physicsrob/vdm1/README.md

This project contains information on the original VDM-1 (Video Display Module) board manufactured by Processor Technologies, as well as a reproduction board referred to as the VDM-2021.

Visit the docs [Here](https://physicsrob.github.io/vdm1)
