physicsrob/vdm1/docs/history/popular electronics Oct 76 review.pdf

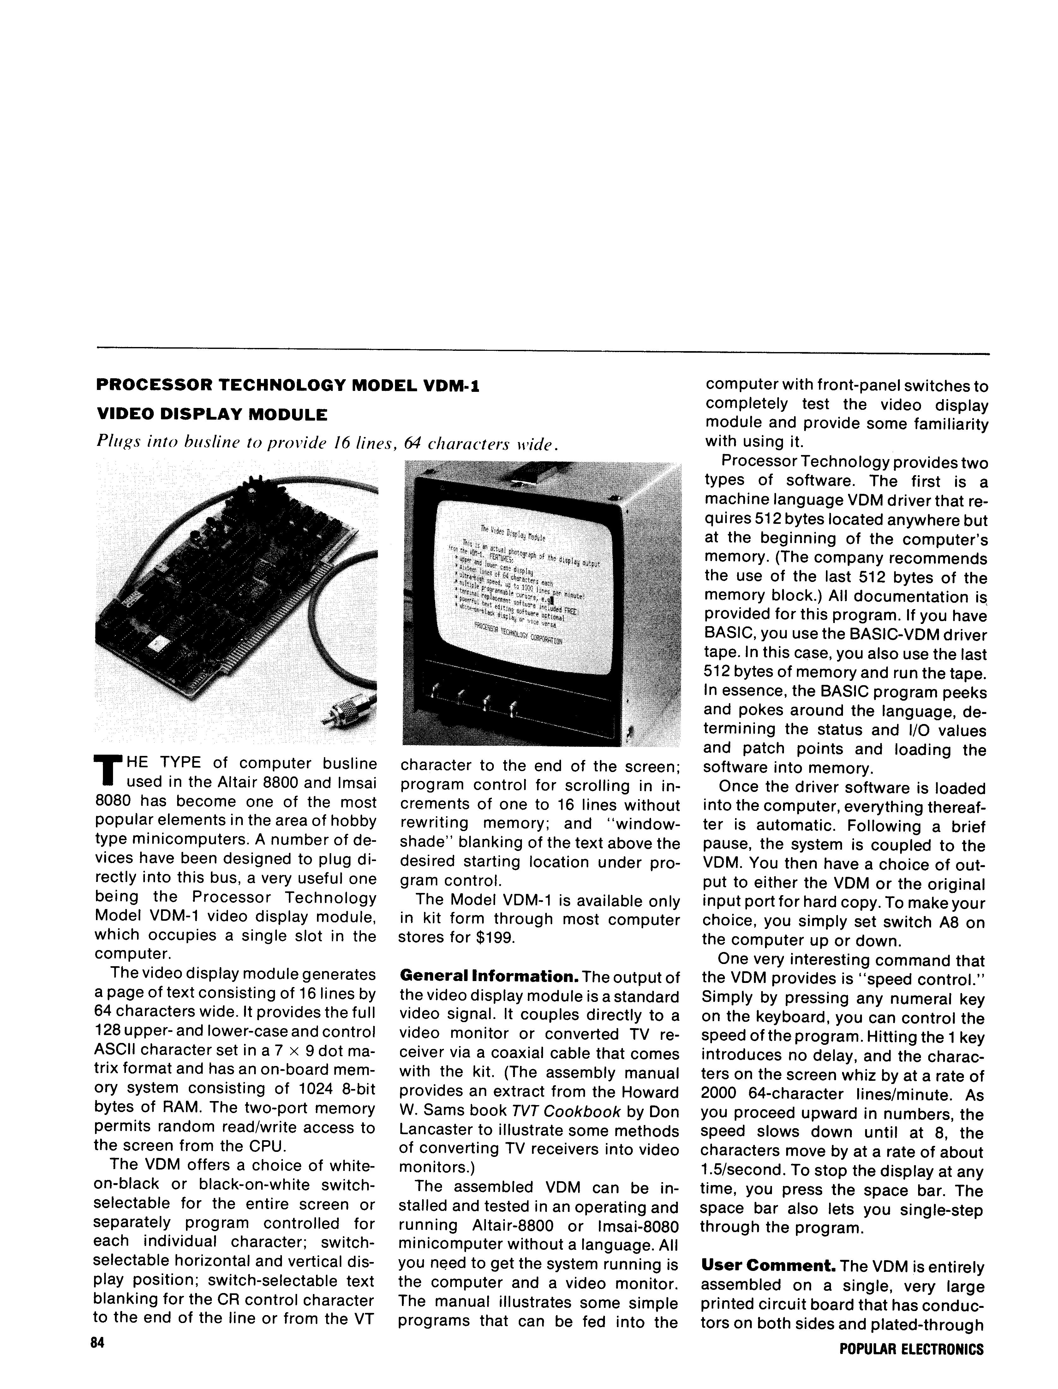
[picture p3: page 1]
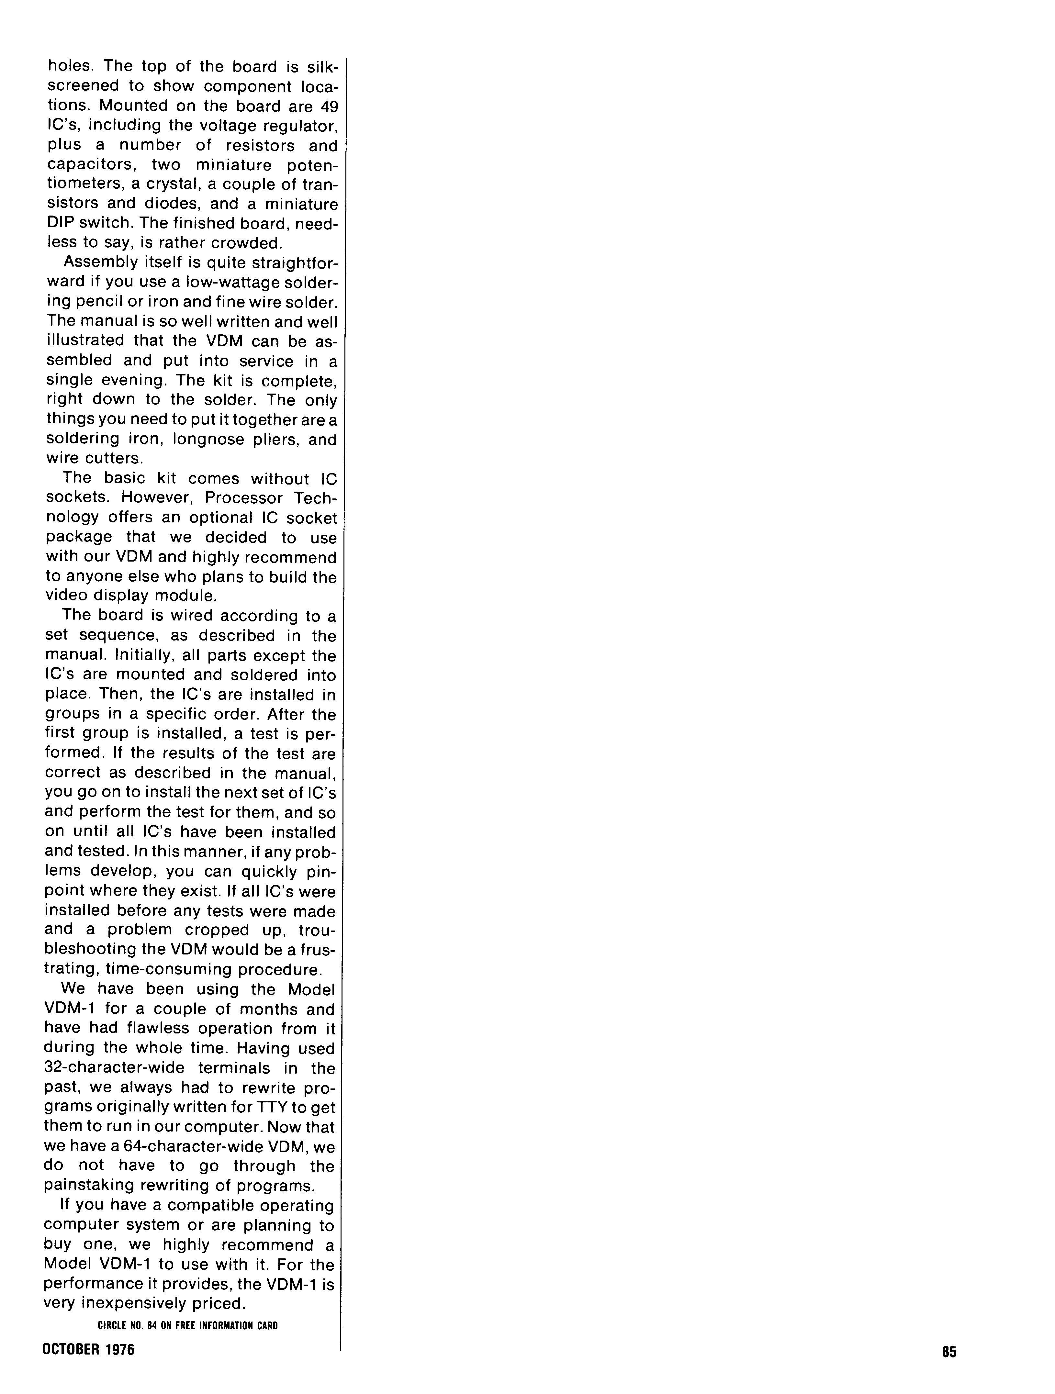
[picture p4: page 2]
