physicsrob/vdm1/docs/history/manuals/schematic rev E.pdf

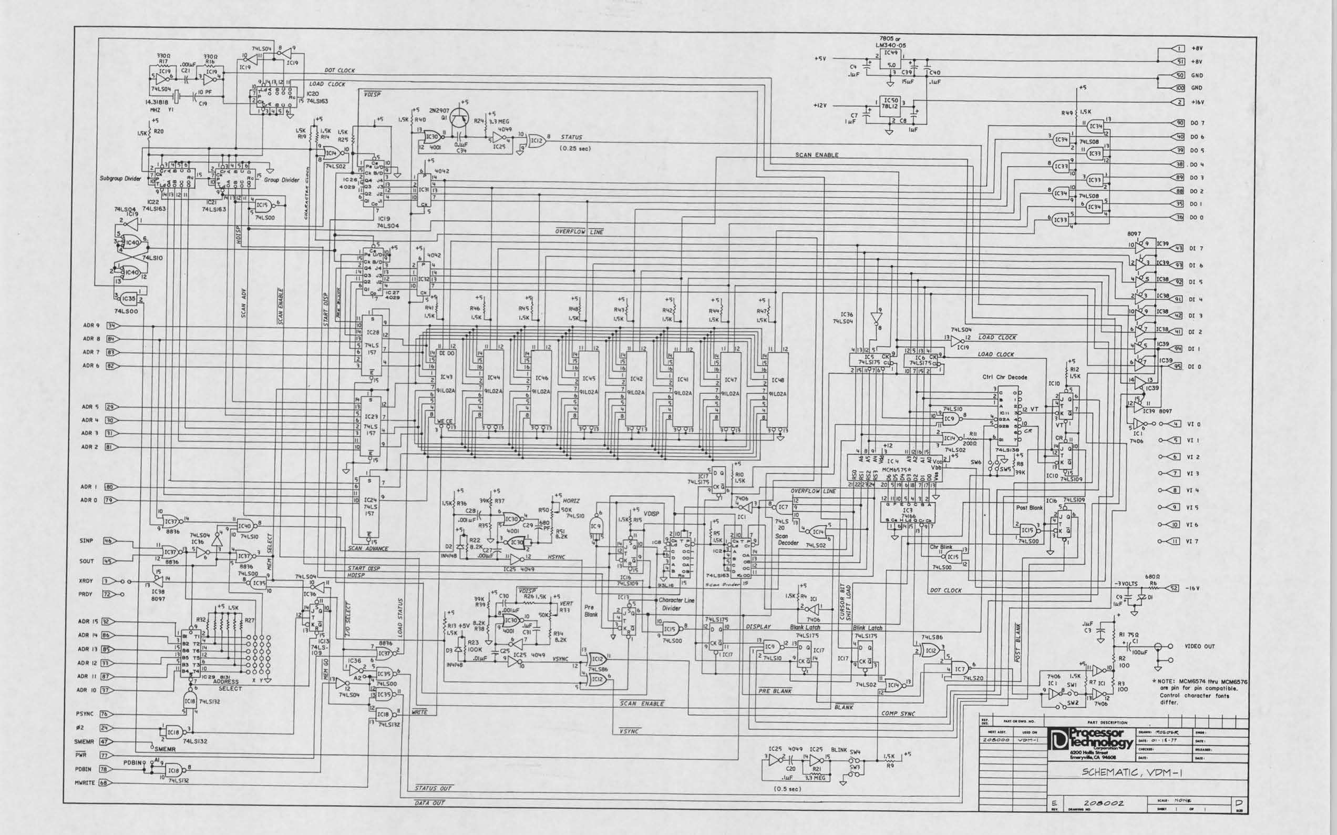
[picture p5: page 1]
