physicsrob/vdm1/docs/images/IC20P12.png

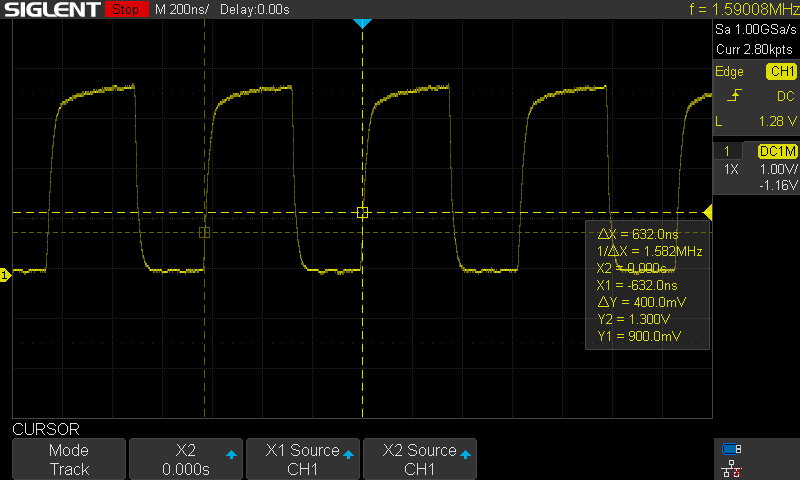
docs/images/IC20P12.png
