physicsrob/vdm1/docs/images/proto_in_chassis.jpg

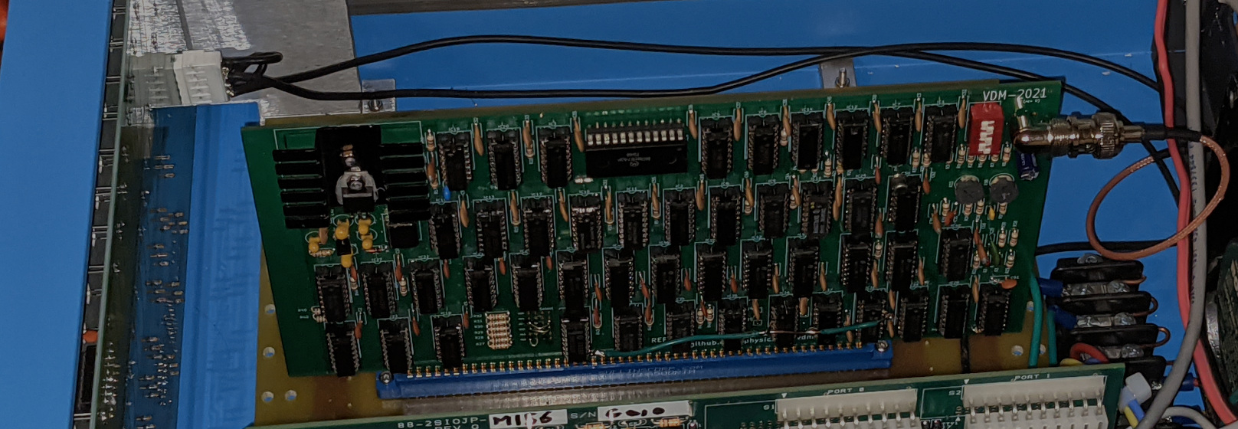
docs/images/proto_in_chassis.jpg
