physicsrob/vdm1/docs/history/manuals/parts rev E.pdf

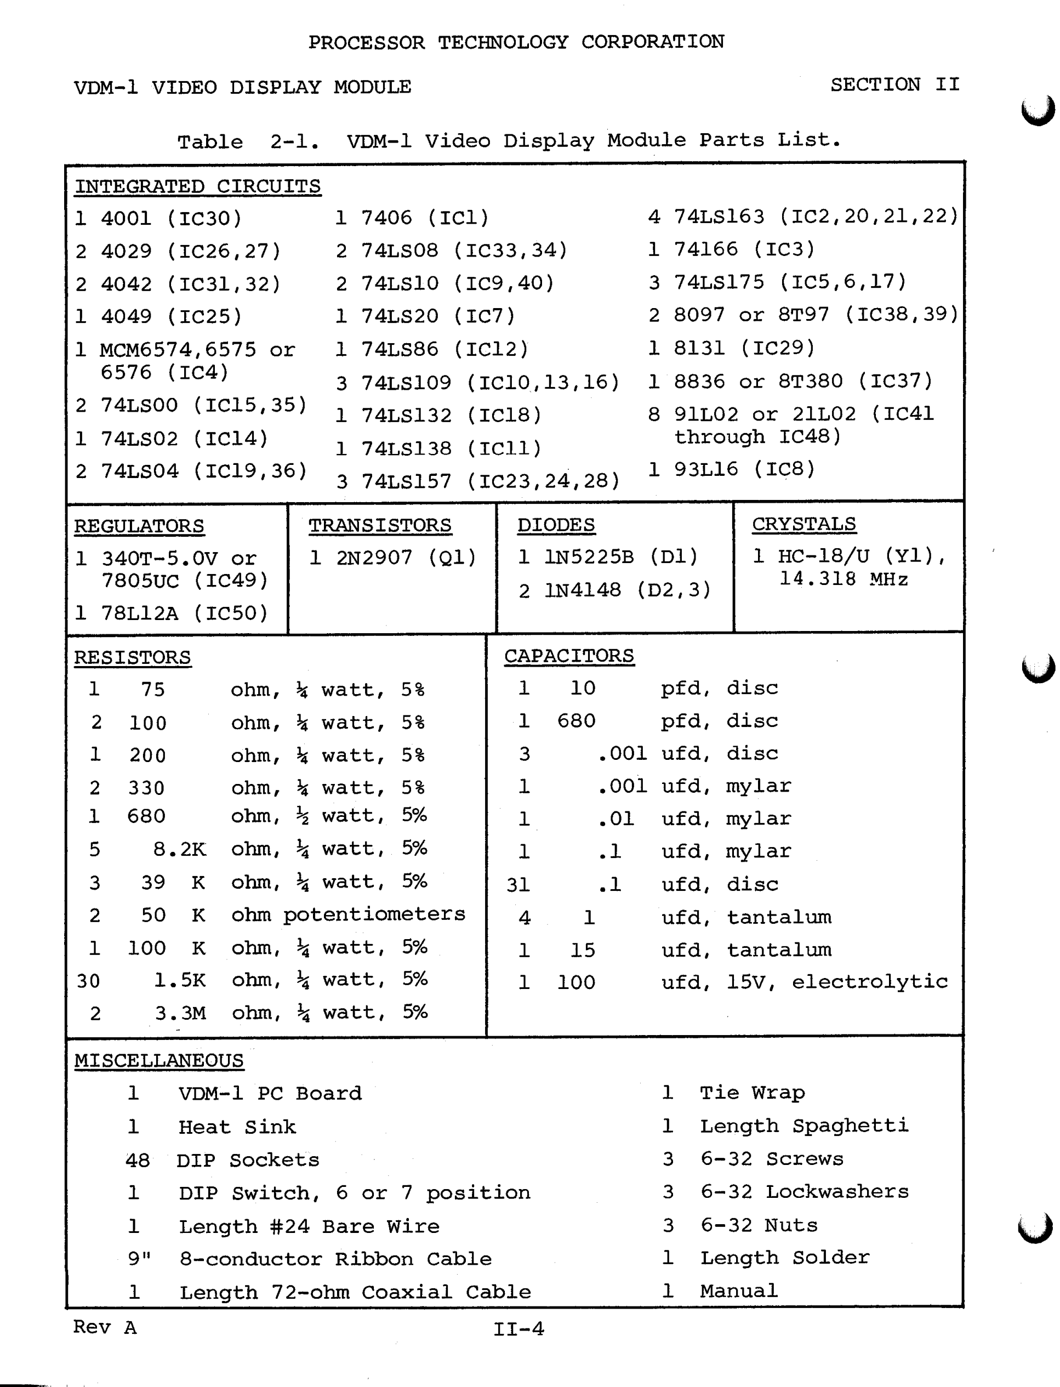
[picture p8: page 1]
