physicsrob/vdm1/docs/history/board images/another VDM1.jpeg

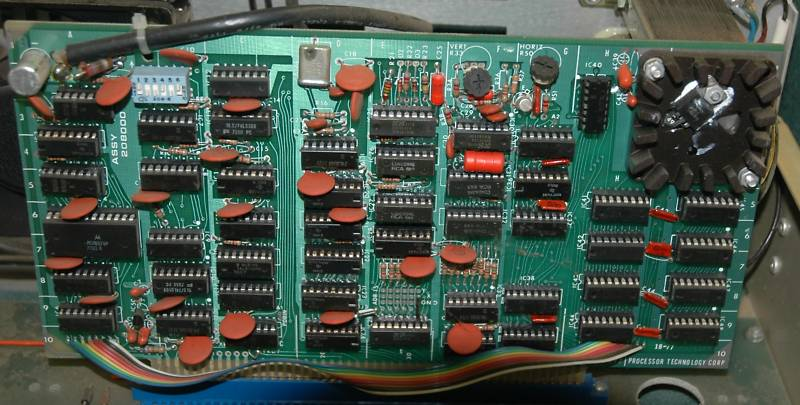
docs/history/board images/another VDM1.jpeg
