physicsrob/vdm1/docs/history/board images/ProcTech VDM1.jpeg

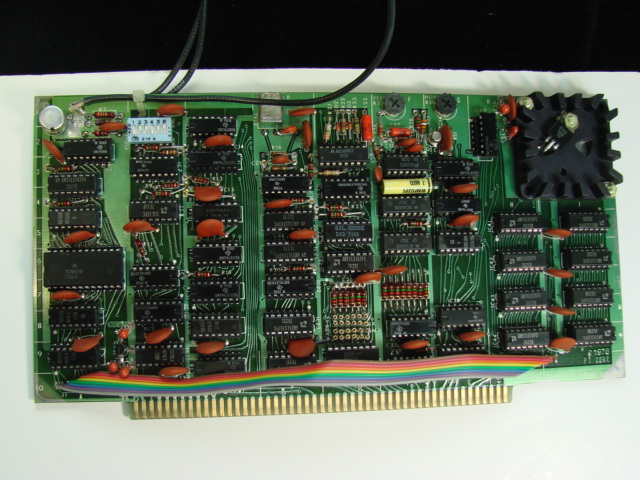
docs/history/board images/ProcTech VDM1.jpeg
