physicsrob/vdm1/docs/history/board images/VDM1-L.jpg

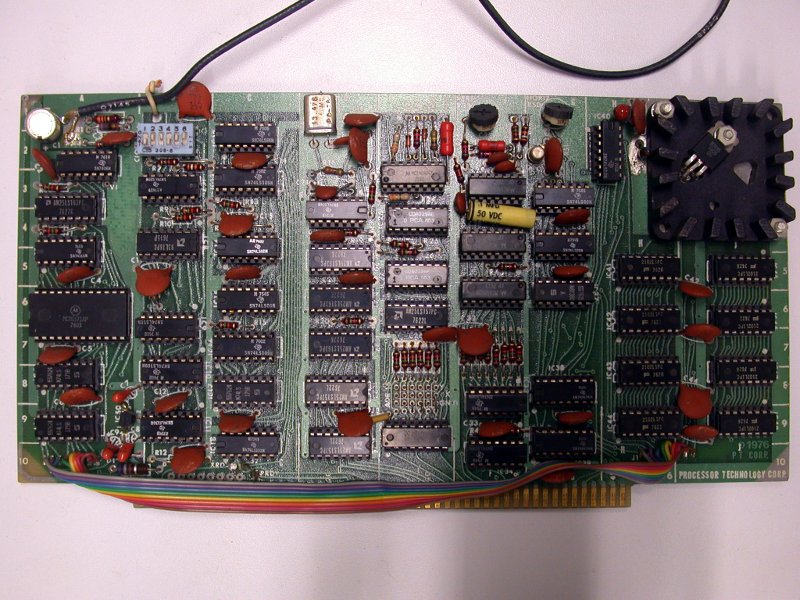
docs/history/board images/VDM1-L.jpg
