physicsrob/vdm1/docs/history/board images/VDM-1 back.jpeg

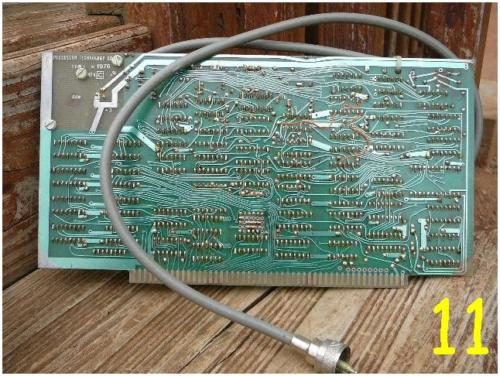
docs/history/board images/VDM-1 back.jpeg
