physicsrob/vdm1/docs/history/board images/VDM-1 front.jpeg

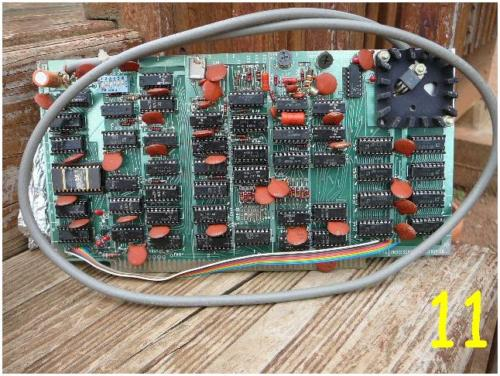
docs/history/board images/VDM-1 front.jpeg
