physicsrob/vdm1/docs/history/board images/VDM-1.jpg

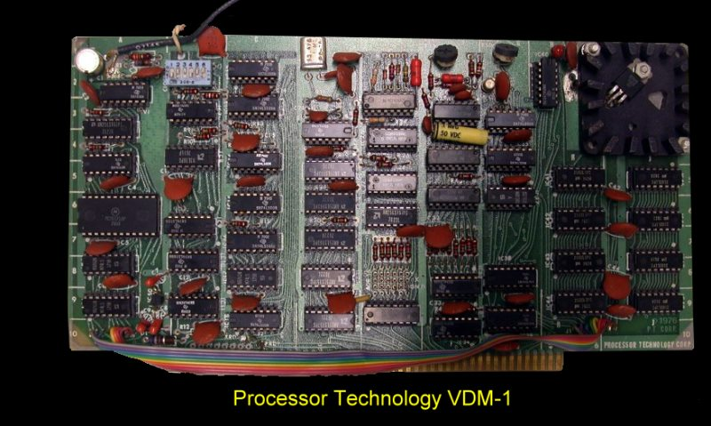
docs/history/board images/VDM-1.jpg
