physicsrob/vdm1/kicad/vdm2021.kicad_pcb

## KiCad design kicad/vdm2021.kicad_pcb (2021-09-07)

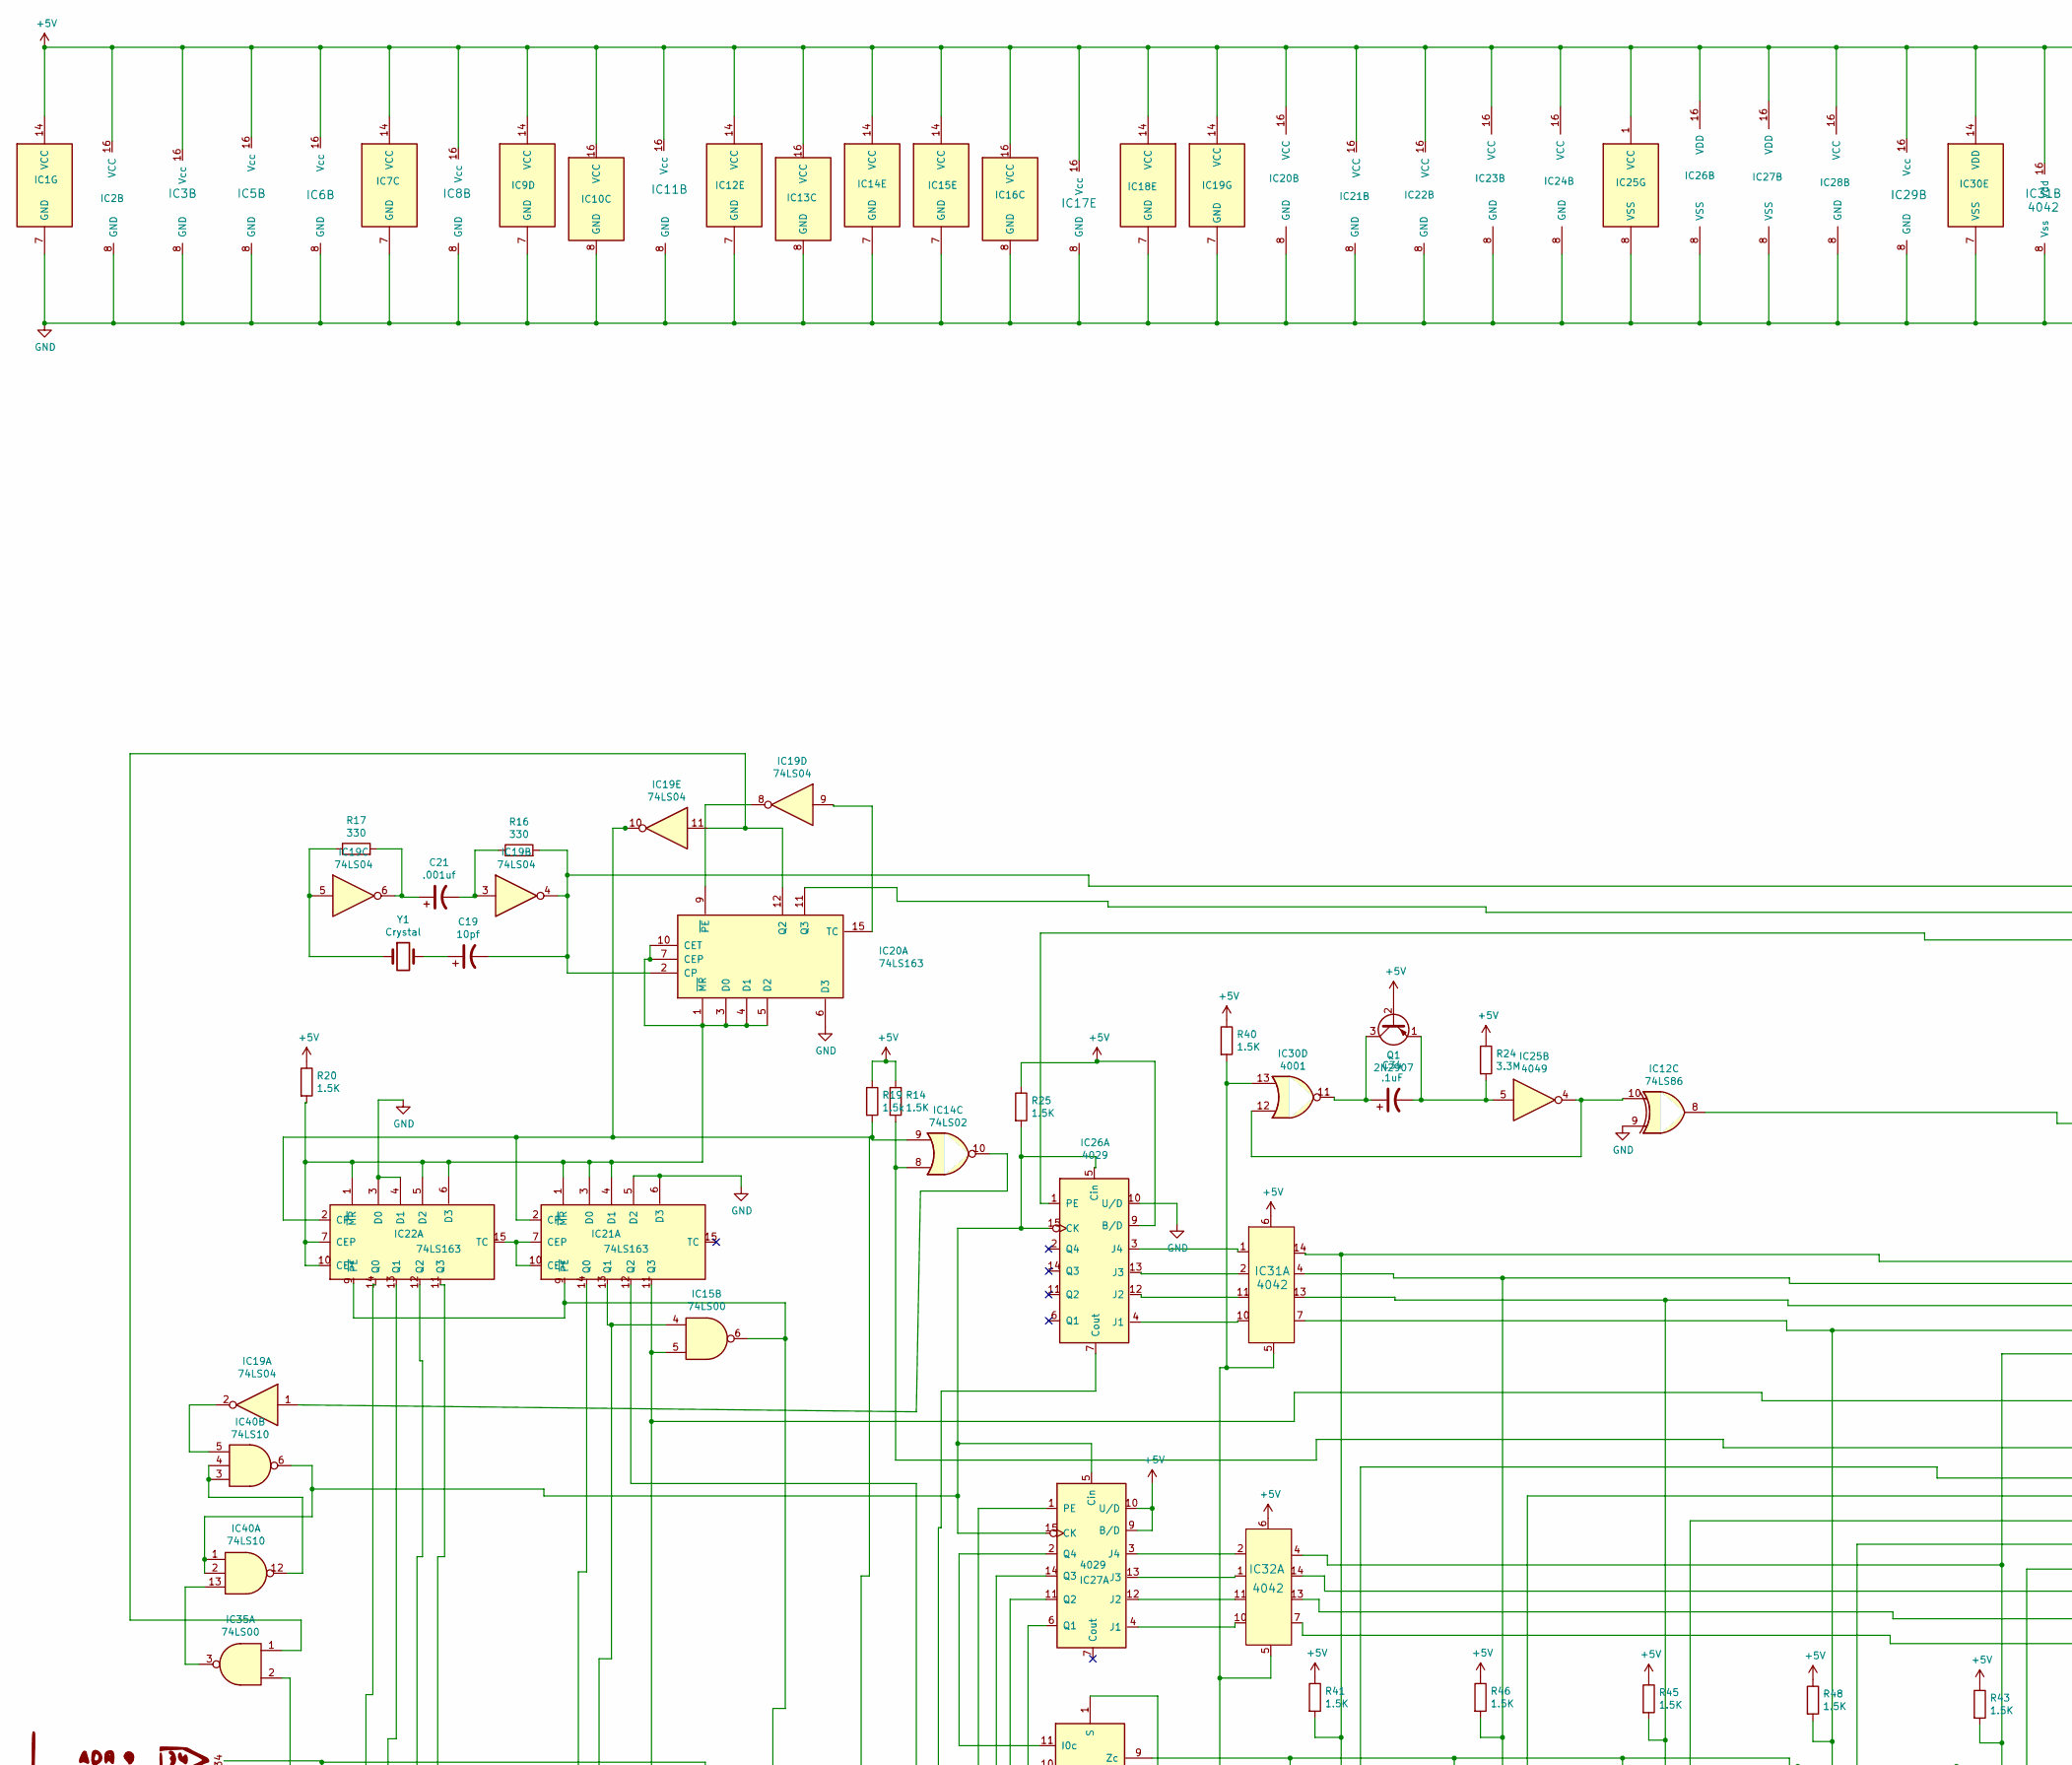
[picture p17: schematic vdm2021.sch, part in row 1, column 1]

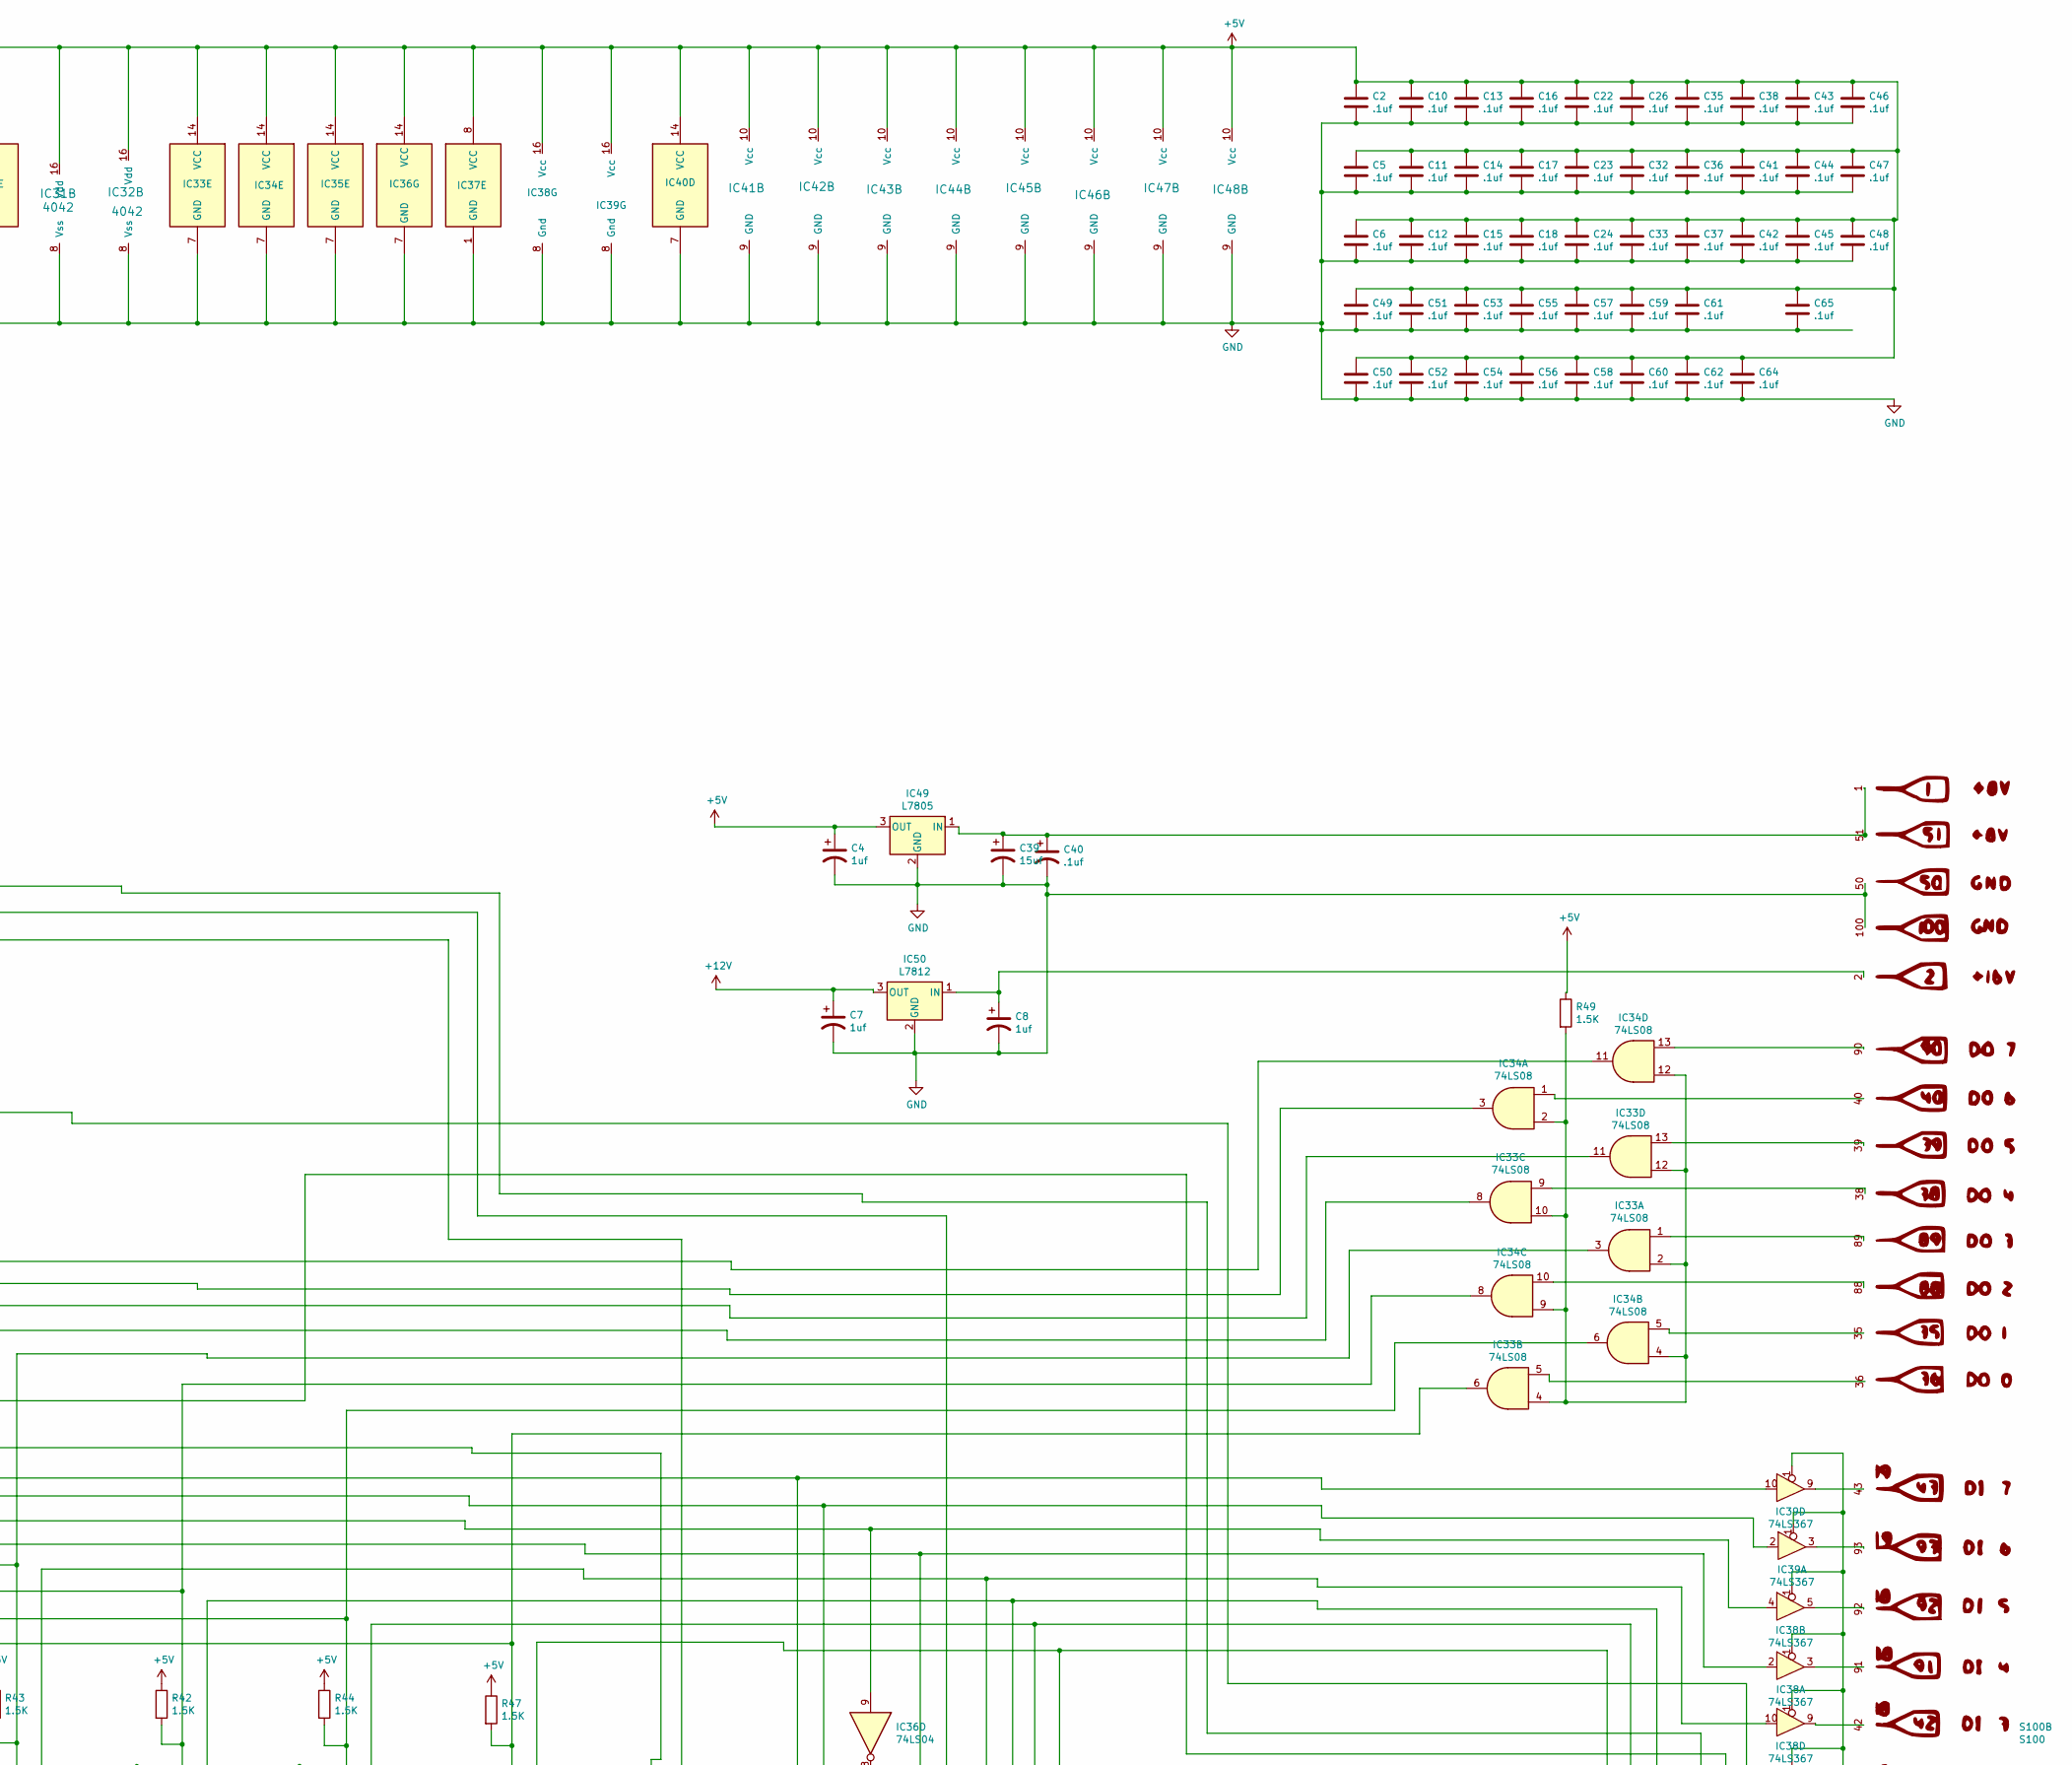
[picture p18: schematic vdm2021.sch, part in row 1, column 2]

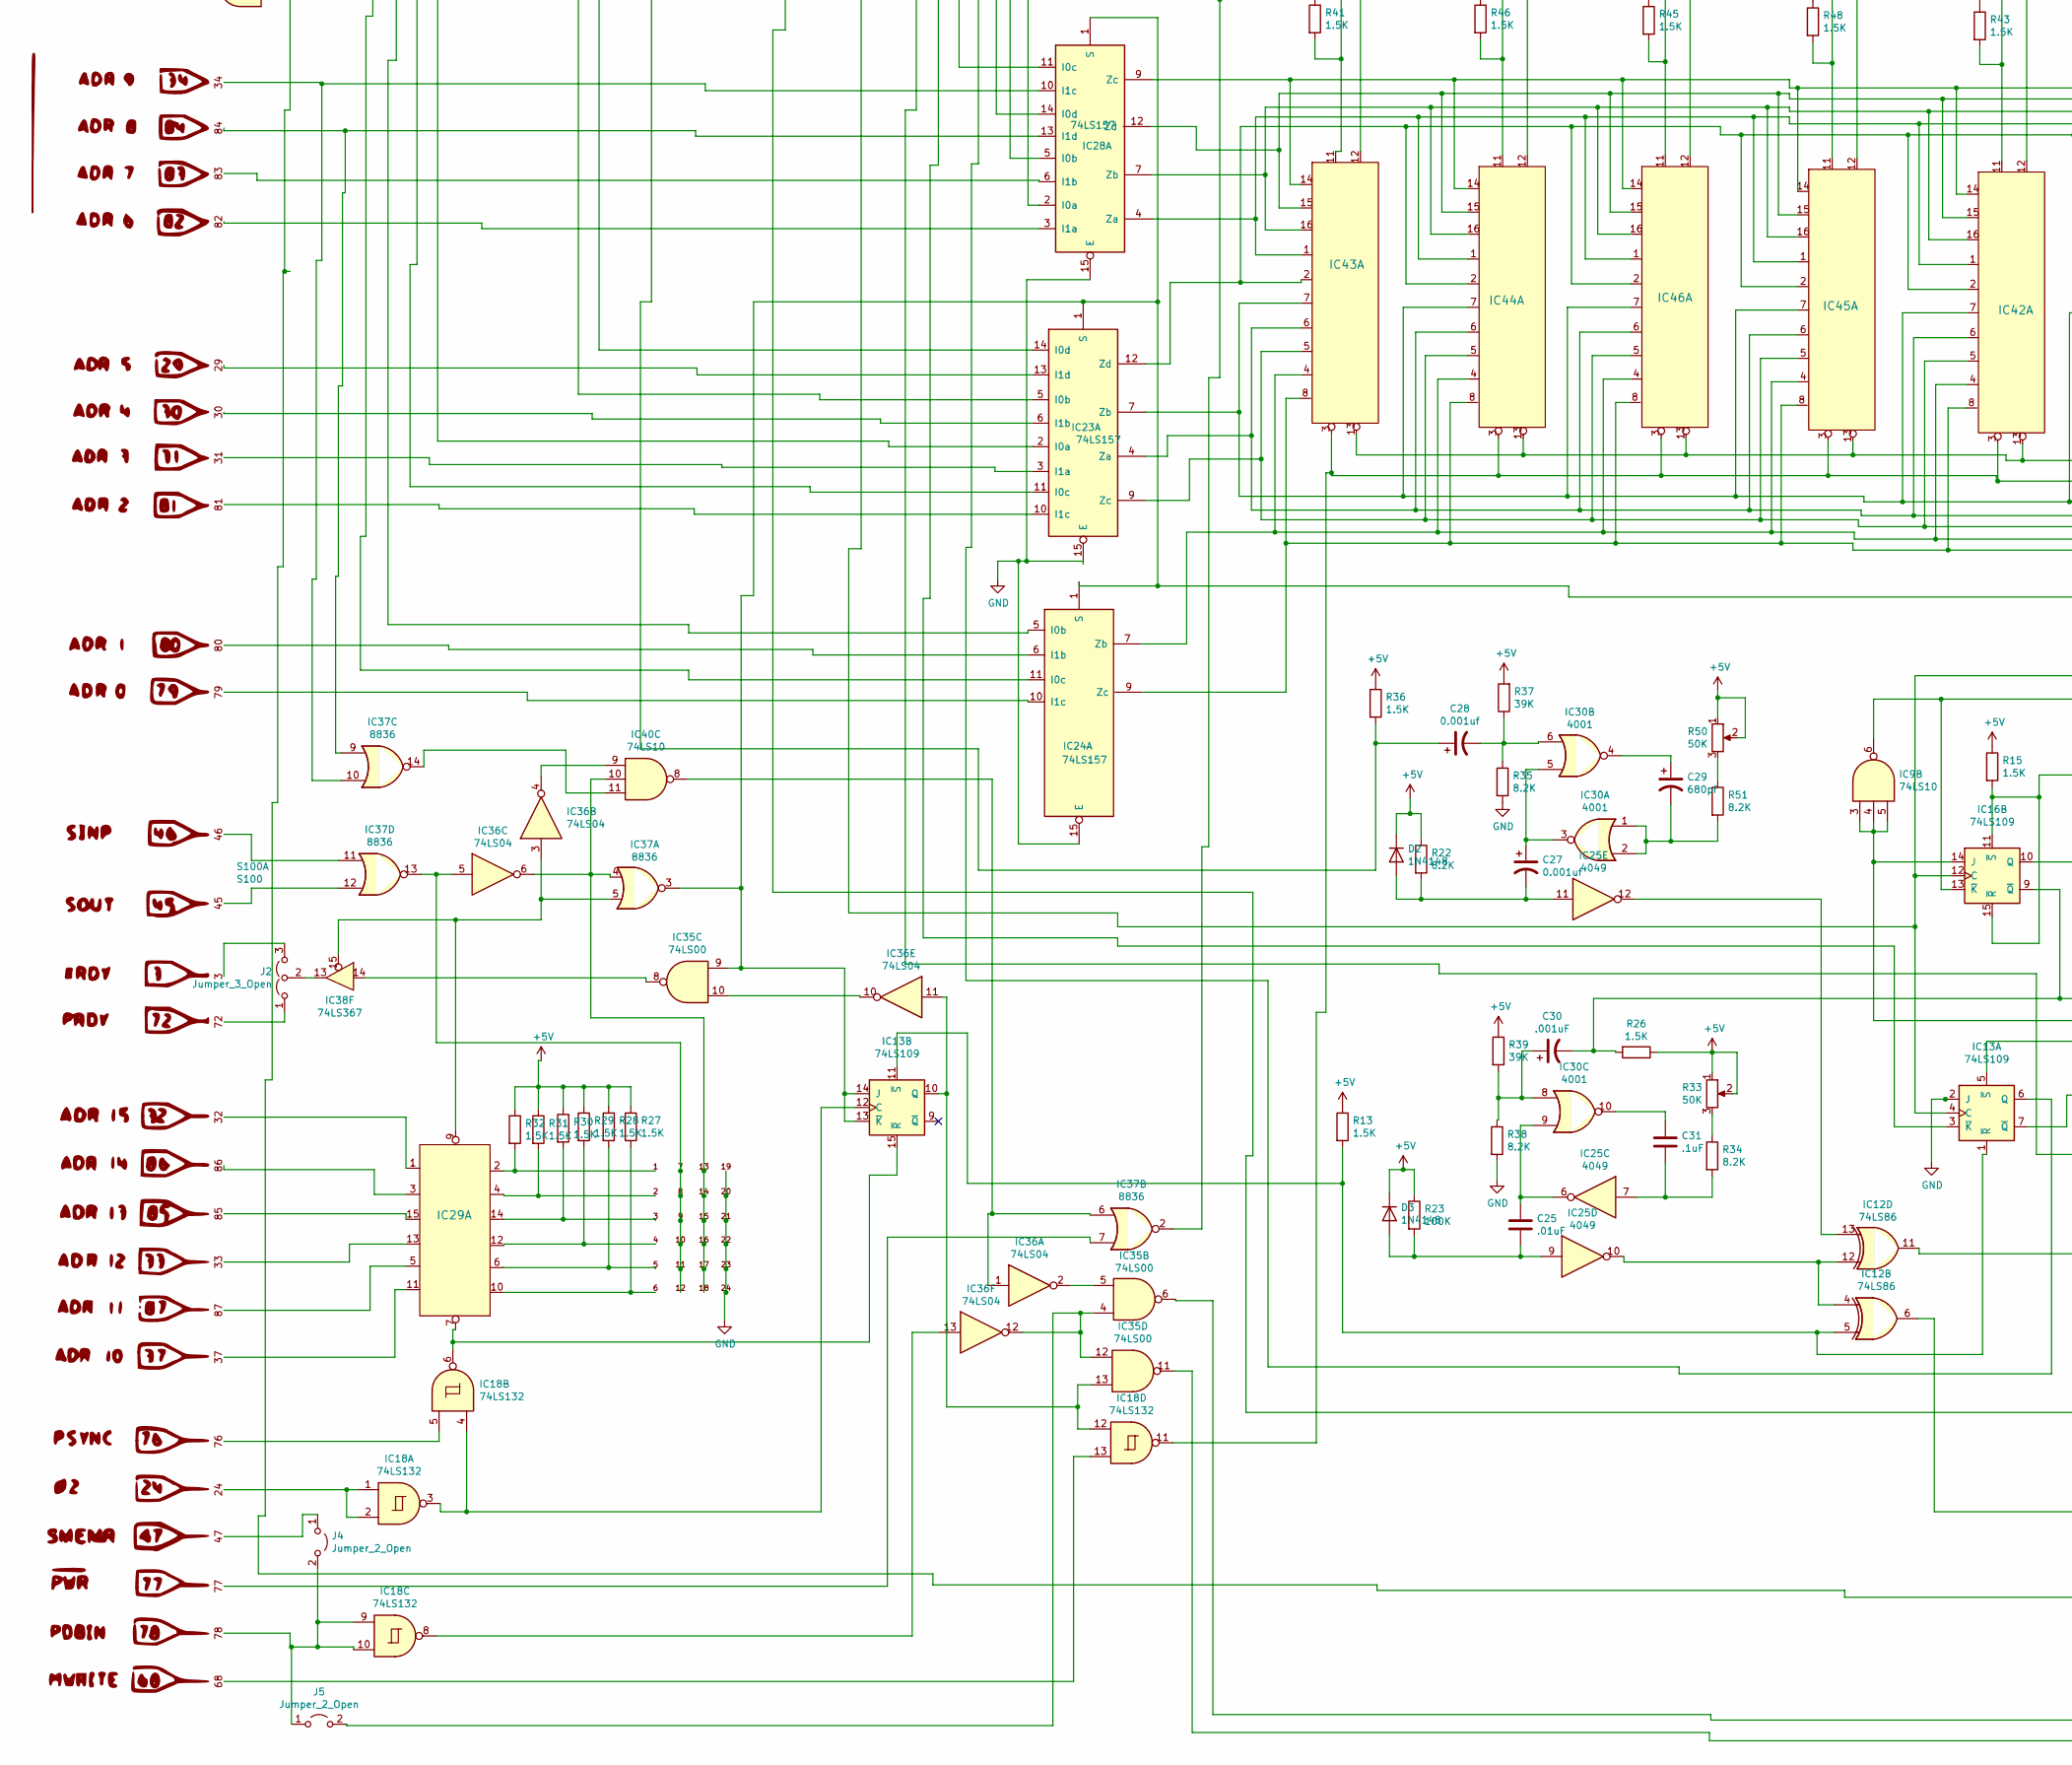
[picture p19: schematic vdm2021.sch, part in row 2, column 1]

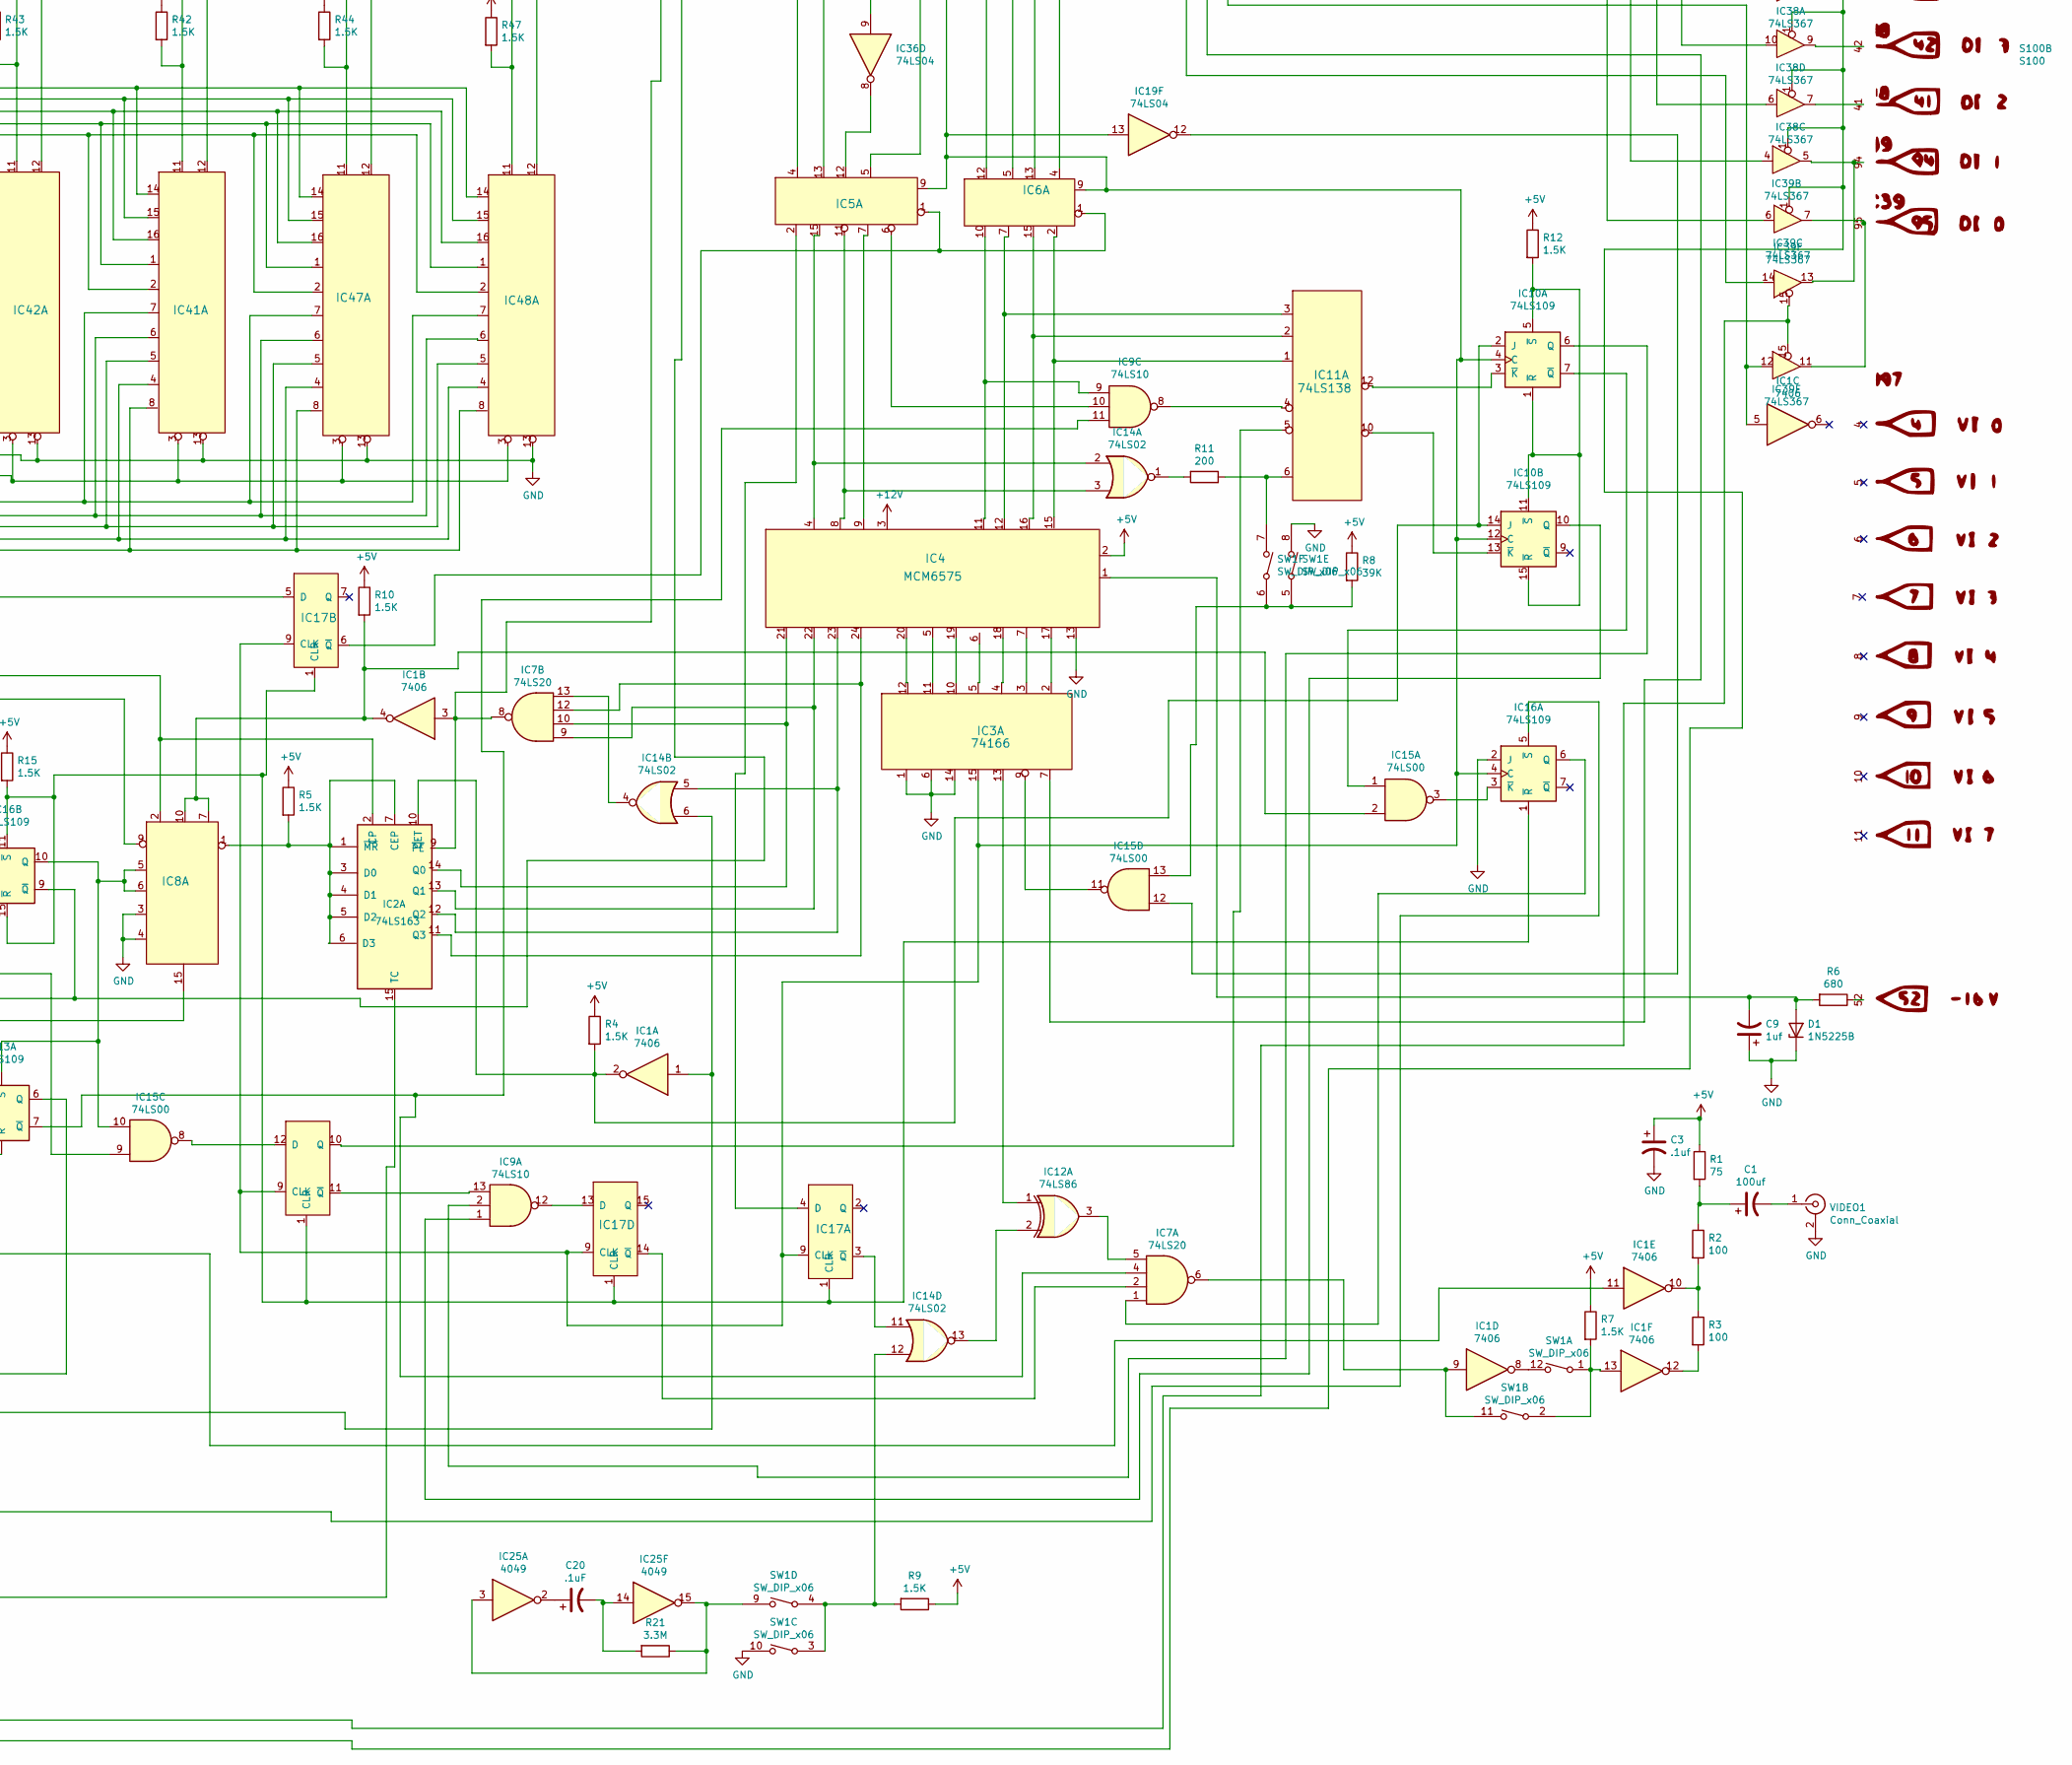
[picture p20: schematic vdm2021.sch, part in row 2, column 2]

Parts:
ADDR1: AddressSelect; ADDR_SELECT
C1: 100uf; CP_Radial_D6.3mm_P2.50mm
C2, C3, C5, C6, C10, C11, C12, C13, C14, C15, C16, C17, C18, C22, C23, C24, C26, C32, C33, C35, C36, C37, C38, C40, C41, C42, C43, C44, C45, C46, C47, C48, C49, C50, C51, C52, C53, C54, C55, C56, C57, C58, C59, C60, C61, C62, C64, C65: .1uf; C_Disc_D6.0mm_W2.5mm_P5.00mm
C4, C7, C8, C9: 1uf; CP_Radial_Tantal_D6.0mm_P2.50mm
C19: 10pf; C_Disc_D6.0mm_W2.5mm_P5.00mm
C20, C31, C34: .1uF; C_Disc_D6.0mm_W2.5mm_P5.00mm
C21: .001uf; C_Disc_D6.0mm_W2.5mm_P5.00mm
C25: .01uF; C_Disc_D6.0mm_W2.5mm_P5.00mm
C27, C28: 0.001uf; C_Disc_D6.0mm_W2.5mm_P5.00mm
C29: 680pf; C_Disc_D3.8mm_W2.6mm_P2.50mm
C30: .001uF; C_Disc_D6.0mm_W2.5mm_P5.00mm
C39: 15uf; CP_Radial_Tantal_D6.0mm_P2.50mm
D1: 1N5225B; D_DO-35_SOD27_P7.62mm_Horizontal
D2, D3: 1N4148; D_DO-35_SOD27_P7.62mm_Horizontal
IC1: 7406; DIP-14_W7.62mm_Socket
IC2, IC20, IC21, IC22: 74LS163; DIP-16_W7.62mm_Socket
IC3: 74166; DIP-16_W7.62mm_Socket
IC4: MCM6575; DIP-24_W15.24mm
IC5, IC6, IC17: 74LS175; DIP-16_W7.62mm_Socket
IC7: 74LS20; DIP-14_W7.62mm_Socket
IC8: 93L16; DIP-16_W7.62mm_Socket
IC9, IC40: 74LS10; DIP-14_W7.62mm_Socket
IC10, IC13, IC16: 74LS109; DIP-16_W7.62mm_Socket
IC11: 74LS138; DIP-16_W7.62mm_Socket
IC12: 74LS86; DIP-14_W7.62mm_Socket
IC14: 74LS02; DIP-14_W7.62mm_Socket
IC15, IC35: 74LS00; DIP-14_W7.62mm_Socket
IC18: 74LS132; DIP-14_W7.62mm_Socket
IC19, IC36: 74LS04; DIP-14_W7.62mm_Socket
IC23, IC24, IC28: 74LS157; DIP-16_W7.62mm_Socket
IC25: 4049; DIP-16_W7.62mm_Socket
IC26, IC27: 4029; DIP-16_W7.62mm_Socket
IC29: DM8131; DIP-16_W7.62mm_Socket
IC30: 4001; DIP-14_W7.62mm_Socket
IC31, IC32: 4042; DIP-16_W7.62mm_Socket
IC33, IC34: 74LS08; DIP-14_W7.62mm_Socket
IC37: 8836; DIP-14_W7.62mm_Socket
IC38, IC39: 74LS367; DIP-16_W7.62mm_Socket
IC41, IC42, IC43, IC44, IC45, IC46, IC47, IC48: 2102; DIP-16_W7.62mm_Socket
IC49: L7805; TO-220-3_Horizontal_TabDown
IC50: L7812; TO-92_Inline_Wide
J2: Jumper_3_Open; PinHeader_1x03_P2.54mm_Vertical
J4, J5: Jumper_2_Open; PinHeader_1x02_P2.54mm_Vertical
Q1: 2N2907; TO-18-3
R1: 75; R_Axial_DIN0207_L6.3mm_D2.5mm_P7.62mm_Horizontal
R2, R3: 100; R_Axial_DIN0207_L6.3mm_D2.5mm_P7.62mm_Horizontal
R4, R5, R7, R9, R10, R12, R13, R14, R15, R20, R25, R26, R27, R28, R29, R30, R31, R32, R36, R40, R41, R42, R43, R44, R45, R46, R47, R48, R49: 1.5K; R_Axial_DIN0207_L6.3mm_D2.5mm_P7.62mm_Horizontal
R6: 680; R_Axial_DIN0207_L6.3mm_D2.5mm_P10.16mm_Horizontal
R8, R37, R39: 39K; R_Axial_DIN0207_L6.3mm_D2.5mm_P7.62mm_Horizontal
R11: 200; R_Axial_DIN0207_L6.3mm_D2.5mm_P7.62mm_Horizontal
R16, R17: 330; R_Axial_DIN0207_L6.3mm_D2.5mm_P7.62mm_Horizontal
R19: 1.5k; R_Axial_DIN0207_L6.3mm_D2.5mm_P7.62mm_Horizontal
R21, R24: 3.3M; R_Axial_DIN0207_L6.3mm_D2.5mm_P7.62mm_Horizontal
R22, R34, R35, R38, R51: 8.2K; R_Axial_DIN0207_L6.3mm_D2.5mm_P7.62mm_Horizontal
R23: 100K; R_Axial_DIN0207_L6.3mm_D2.5mm_P7.62mm_Horizontal
R33, R50: 50K; Potentiometer_ACP_CA9-H2,5_Horizontal
S100: S100; S100_MALE
SW1: SW_DIP_x06; SW_DIP_SPSTx06_Slide_9.78x17.42mm_W7.62mm_P2.54mm
VIDEO1: Conn_Coaxial; bnc-5-16345033
Y1: Crystal; Crystal_HC50_Horizontal

Connections:
+5V: C2.1, C3.1, C4.1, C5.1, C6.1, C10.1, C11.1, C12.1, C13.1, C14.1, C15.1, C16.1, C17.1, C18.1, C22.1, C23.1, C24.1, C26.1, C32.1, C33.1, C35.1, C36.1, C37.1, C38.1, C41.1, C42.1, C43.1, C44.1, C45.1, C46.1, C47.1, C48.1, C49.1, C50.1, C51.1, C52.1, C53.1, C54.1, C55.1, C56.1, C57.1, C58.1, C59.1, C60.1, C61.1, C62.1, C64.1, C65.1, D2.1 (K), D3.1 (K), IC1.14 (VCC), IC2.16 (VCC), IC3.16 (Vcc), IC4.2, IC5.16 (Vcc), IC6.16 (Vcc), IC7.14 (VCC), IC8.16 (Vcc), IC9.14 (VCC), IC10.16 (VCC), IC11.16 (Vcc), IC12.14 (VCC), IC13.16 (VCC), IC14.14 (VCC), IC15.14 (VCC), IC16.16 (VCC), IC17.16 (Vcc), IC18.14 (VCC), IC19.14 (VCC), IC20.16 (VCC), IC21.16 (VCC), IC22.16 (VCC), IC23.16 (VCC), IC24.16 (VCC), IC25.1 (VCC), IC26.9 (B/D), IC26.16 (VDD), IC27.9 (B/D), IC27.10 (U/D), IC27.16 (VDD), IC28.16 (VCC), IC29.16 (Vcc), IC30.14 (VDD), IC31.6, IC31.16 (Vdd), IC32.6, IC32.16 (Vdd), IC33.14 (VCC), IC34.14 (VCC), IC35.14 (VCC), IC36.14 (VCC), IC37.8 (VCC), IC38.16 (Vcc), IC39.16 (Vcc), IC40.14 (VCC), IC41.10 (Vcc), IC42.10 (Vcc), IC43.10 (Vcc), IC44.10 (Vcc), IC45.10 (Vcc), IC46.10 (Vcc), IC47.10 (Vcc), IC48.10 (Vcc), IC49.3 (OUT), Q1.2 (B), R1.1, R4.1, R5.1, R7.1, R8.1, R9.1, R10.1, R12.1, R13.1, R14.1, R15.1, R19.1, R20.1, R22.1, R23.1, R24.1, R25.1, R26.1, R27.1, R28.1, R29.1, R30.1, R31.1, R32.1, R33.1, R33.2, R36.1, R37.2, R39.1, R40.1, R41.1, R42.1, R43.1, R44.1, R45.1, R46.1, R47.1, R48.1, R49.1, R50.1, R50.2
+12V: C7.1, IC4.3, IC50.3 (OUT)
GND: ADDR1.19, ADDR1.20, ADDR1.21, ADDR1.22, ADDR1.23, ADDR1.24, C2.2, C3.2, C4.2, C5.2, C6.2, C7.2, C8.2, C9.1, C10.2, C11.2, C12.2, C13.2, C14.2, C15.2, C16.2, C17.2, C18.2, C22.2, C23.2, C24.2, C26.2, C32.2, C33.2, C35.2, C36.2, C37.2, C38.2, C39.2, C40.2, C41.2, C42.2, C43.2, C44.2, C45.2, C46.2, C47.2, C48.2, C49.2, C50.2, C51.2, C52.2, C53.2, C54.2, C55.2, C56.2, C57.2, C58.2, C59.2, C60.2, C61.2, C62.2, C64.2, C65.2, D1.1 (K), IC1.7 (GND), IC2.8 (GND), IC3.1, IC3.6, IC3.8 (GND), IC3.14, IC4.13, IC5.8 (GND), IC6.8 (GND), IC7.7 (GND), IC8.3, IC8.4, IC8.8 (GND), IC9.7 (GND), IC10.8 (GND), IC11.8 (GND), IC12.7 (GND), IC12.9, IC13.2 (J), IC13.8 (GND), IC14.7 (GND), IC15.7 (GND), IC16.2 (J), IC16.8 (GND), IC17.8 (GND), IC18.7 (GND), IC19.7 (GND), IC20.6 (D3), IC20.8 (GND), IC21.5 (D2), IC21.6 (D3), IC21.8 (GND), IC22.3 (D0), IC22.4 (D1), IC22.8 (GND), IC23.8 (GND), IC23.15 (E), IC24.8 (GND), IC24.15 (E), IC25.8 (VSS), IC26.8 (VSS), IC26.10 (U/D), IC27.8 (VSS), IC28.8 (GND), IC28.15 (E), IC29.8 (GND), IC30.7 (VSS), IC31.8 (Vss), IC32.8 (Vss), IC33.7 (GND), IC34.7 (GND), IC35.7 (GND), IC36.7 (GND), IC37.1 (GND), IC38.8 (Gnd), IC39.8 (Gnd), IC40.7 (GND), IC41.9 (GND), IC41.13, IC42.9 (GND), IC42.13, IC43.9 (GND), IC43.13, IC44.9 (GND), IC44.13, IC45.9 (GND), IC45.13, IC46.9 (GND), IC46.13, IC47.9 (GND), IC47.13, IC48.9 (GND), IC48.13, IC49.2 (GND), IC50.2 (GND), R35.2, R38.2, S100.50, S100.100, SW1.8, SW1.10, VIDEO1.2 (Ext); also elsewhere on the board
unnamed: ADDR1.1, IC29.2, R32.2
unnamed: ADDR1.2, IC29.4, R31.2
unnamed: ADDR1.3, IC29.14, R30.2
unnamed: ADDR1.4, IC29.12, R29.2
unnamed: ADDR1.5, IC29.6, R28.2
unnamed: ADDR1.6, IC29.10, R27.2
unnamed: ADDR1.7, ADDR1.8, ADDR1.9, ADDR1.10, ADDR1.11, ADDR1.12, IC36.5, IC37.13
unnamed: ADDR1.13, ADDR1.14, ADDR1.15, ADDR1.16, ADDR1.17, ADDR1.18, IC36.6, IC37.4, IC40.10
unnamed: C1.1, R1.2, R2.1
unnamed 12: C1.2, VIDEO1.1 (In); also elsewhere on the board
unnamed: C8.1, IC50.1 (IN), S100.2
unnamed: C9.2, D1.2 (A), IC4.1, R6.2
unnamed: C19.1, Y1.2
unnamed: C19.2, IC3.7, IC19.4, IC20.2 (CP), R16.2
unnamed: C20.1, IC25.2
unnamed: C20.2, IC25.14, R21.2
unnamed: C21.1, IC19.6, R17.2
unnamed: C21.2, IC19.3, R16.1
unnamed: C25.1, IC25.6, IC30.9
unnamed: C25.2, D3.2 (A), IC25.9, R23.2
unnamed: C27.1, IC30.3, IC30.5
unnamed: C27.2, D2.2 (A), IC25.11, R22.2
unnamed: C28.1, IC15.5, IC21.11 (Q3), IC39.14, R36.2
unnamed: C28.2, IC30.6, R35.1, R37.1
unnamed: C29.1, IC30.4
unnamed: C29.2, IC30.1, IC30.2, R51.2
unnamed: C30.1, IC30.8, R38.1, R39.2
unnamed: C30.2, IC16.9 (~Q), IC26.1 (PE), R26.2
unnamed: C31.1, IC30.10
unnamed: C31.2, IC25.7, R34.2
unnamed: C34.1, IC30.11, Q1.3 (C)
unnamed: C34.2, IC25.5, Q1.1 (E), R24.2
unnamed: C39.1, C40.1, IC49.1 (IN), S100.1, S100.51
unnamed: IC1.1, IC14.6, IC15.6, IC21.9 (~PE), IC22.9 (~PE)
unnamed: IC1.2, IC2.10 (CET), IC10.2 (J), IC10.14 (J), R4.2
unnamed: IC1.3, IC2.9 (~PE), IC7.8, IC14.8, R14.2
unnamed: IC1.4, IC8.7, IC8.10, IC15.2, R10.2
unnamed: IC1.5, IC12.8, IC39.12
unnamed: IC1.8, SW1.12
unnamed: IC1.9, IC7.6, SW1.11
unnamed: IC1.10, R2.2, R3.1
unnamed: IC1.11, IC12.11
unnamed: IC1.12, R3.2
unnamed: IC1.13, R7.2, SW1.1, SW1.2
unnamed: IC2.1 (~MR), IC2.3 (D0), IC2.4 (D1), IC2.5 (D2), IC2.6 (D3), IC2.7 (CEP), IC8.1, R5.2
unnamed: IC2.11 (Q3), IC4.24, IC7.12
unnamed: IC2.13 (Q1), IC4.22, IC7.9
unnamed: IC2.14 (Q0), IC4.21, IC7.10
unnamed: IC2.15 (TC), IC35.2
unnamed: IC3.2, IC4.17
unnamed: IC3.3, IC4.7
unnamed: IC3.4, IC4.18
unnamed: IC3.5, IC4.6
unnamed: IC3.10, IC4.19
unnamed: IC3.11, IC4.5
unnamed: IC3.12, IC4.20
unnamed: IC4.9, IC5.7
unnamed: IC4.11, IC6.10, IC9.9
unnamed: IC5.6, IC9.10
unnamed: IC10.1 (~R), IC10.5 (~S), IC10.11 (~S), IC10.15 (~R), R12.2
unnamed: IC10.3 (~K), IC11.12
unnamed: IC9.2, IC10.6 (Q)
unnamed: IC10.7 (~Q), IC15.1
unnamed: IC9.1, IC10.10 (Q)
unnamed: IC3.15, IC5.9, IC6.9, IC10.4 (C), IC10.12 (C), IC16.4 (C), IC17.9 (CLK), IC19.13, IC20.11 (Q3)
unnamed: IC10.13 (~K), IC11.10
unnamed: IC4.15, IC6.2, IC11.1
unnamed: IC4.16, IC6.15, IC11.2
unnamed: IC4.12, IC6.7, IC11.3
unnamed: IC9.8, IC11.4
unnamed: IC11.5, IC17.10 (Q)
unnamed: IC11.6, R11.1, SW1.7
unnamed: IC3.13, IC12.1
unnamed: IC12.2, IC14.13
unnamed: IC7.5, IC12.3
unnamed: IC12.5, IC13.1 (~R), IC13.11 (~S), R13.2
unnamed: IC12.6, IC16.5 (~S)
unnamed: IC12.10, IC25.4, IC30.12
unnamed: IC12.4, IC12.12, IC25.10
unnamed: IC12.13, IC25.12
unnamed: IC13.3 (~K), IC26.7 (Cout)
unnamed: IC2.2 (CP), IC8.2, IC13.4 (C), IC14.9, IC16.12 (C), IC19.10, IC21.2 (CP), IC22.2 (CP), R19.2
unnamed: IC8.5, IC8.6, IC13.5 (~S), IC15.10, IC16.10 (Q)
unnamed: IC13.6 (Q), IC27.1 (PE)
unnamed: IC7.4, IC9.11, IC13.7 (~Q)
unnamed: IC13.10 (Q), IC18.12, IC35.13, IC36.11
unnamed: IC13.12 (C), IC18.3, IC18.4
unnamed: IC13.13 (~K), IC13.14 (J), IC17.5 (D), IC23.1 (S), IC24.1 (S), IC28.1 (S), IC35.9, IC37.3
unnamed: IC13.15 (~R), IC18.6, IC29.7
unnamed: IC14.1, R11.2
unnamed: IC4.4, IC5.15, IC14.2
unnamed: IC4.8, IC5.11, IC14.3
unnamed: IC7.13, IC14.4
unnamed: IC2.12 (Q2), IC4.23, IC14.5
unnamed: IC14.10, IC19.1
unnamed: IC14.11, IC17.3 (~Q)
unnamed: IC14.12, R9.2, SW1.3, SW1.4
unnamed: IC15.3, IC16.3 (~K)
unnamed: IC15.4, IC21.13 (Q1), IC23.14 (I0d)
unnamed: IC15.8, IC17.12 (D)
unnamed: IC15.9, IC21.12 (Q2)
unnamed: IC3.9, IC15.11
unnamed: IC15.12, IC19.12
unnamed: IC15.13, R8.2, SW1.5, SW1.6
unnamed: IC16.1 (~R), IC16.11 (~S), IC16.15 (~R), IC17.1 (CLR), R15.2
unnamed: IC7.1, IC16.6 (Q)
unnamed: IC8.9, IC9.6, IC16.13 (~K)
unnamed: IC8.15, IC9.3, IC9.4, IC9.5, IC16.14 (J)
unnamed: IC5.2, IC17.4 (D)
unnamed: IC5.1, IC6.1, IC17.6 (~Q)
unnamed: IC9.13, IC17.11 (~Q)
unnamed: IC9.12, IC17.13 (D)
unnamed: IC7.2, IC17.14 (~Q)
unnamed: IC18.1, IC18.2, S100.24
unnamed: IC18.5, S100.76
unnamed: IC18.8, IC36.13
unnamed: IC18.9, IC18.10, J4.2 (B), J5.1 (A), S100.78
unnamed: IC18.11, IC41.3, IC42.3, IC43.3, IC44.3, IC45.3, IC46.3, IC47.3, IC48.3
unnamed: IC18.13, S100.68
unnamed: IC19.2, IC40.5
unnamed: IC19.5, R17.1, Y1.1
unnamed: IC19.8, IC20.9 (~PE)
unnamed: IC19.9, IC20.15 (TC)
unnamed: IC19.11, IC20.12 (Q2), IC35.1
unnamed: IC20.1 (~MR), IC20.3 (D0), IC20.4 (D1), IC20.5 (D2), IC20.7 (CEP), IC20.10 (CET), IC21.1 (~MR), IC21.3 (D0), IC21.4 (D1), IC22.1 (~MR), IC22.5 (D2), IC22.6 (D3), IC22.7 (CEP), IC22.10 (CET), R20.2
unnamed: IC21.7 (CEP), IC21.10 (CET), IC22.15 (TC)
unnamed: IC21.14 (Q0), IC23.5 (I0b)
unnamed: IC22.11 (Q3), IC23.2 (I0a)
unnamed: IC22.12 (Q2), IC23.11 (I0c)
unnamed: IC22.13 (Q1), IC24.5 (I0b)
unnamed: IC22.14 (Q0), IC24.11 (I0c)
unnamed: IC23.3 (I1a), S100.31
unnamed: IC23.4 (Za), IC41.6, IC42.6, IC43.6, IC44.6, IC45.6, IC46.6, IC47.6, IC48.6
unnamed: IC23.6 (I1b), S100.30
unnamed: IC23.7 (Zb), IC41.7, IC42.7, IC43.7, IC44.7, IC45.7, IC46.7, IC47.7, IC48.7
unnamed: IC23.9 (Zc), IC41.5, IC42.5, IC43.5, IC44.5, IC45.5, IC46.5, IC47.5, IC48.5
unnamed: IC23.10 (I1c), S100.81
unnamed: IC23.12 (Zd), IC41.2, IC42.2, IC43.2, IC44.2, IC45.2, IC46.2, IC47.2, IC48.2
unnamed: IC23.13 (I1d), S100.29
unnamed: IC24.6 (I1b), S100.80
unnamed: IC24.7 (Zb), IC41.4, IC42.4, IC43.4, IC44.4, IC45.4, IC46.4, IC47.4, IC48.4
unnamed: IC24.9 (Zc), IC41.8, IC42.8, IC43.8, IC44.8, IC45.8, IC46.8, IC47.8, IC48.8
unnamed: IC24.10 (I1c), S100.79
unnamed: IC25.3, IC25.15, R21.1, SW1.9
unnamed: IC26.3 (J4), IC31.1
unnamed: IC26.4 (J1), IC31.10
unnamed: IC26.12 (J2), IC31.11
unnamed: IC26.13 (J3), IC31.2
unnamed: IC26.5 (Cin), IC26.15 (CK), IC27.5 (Cin), IC27.15 (CK), IC40.1, IC40.2, IC40.6, R25.2
unnamed: IC27.2 (Q4), IC28.11 (I0c)
unnamed: IC27.3 (J4), IC32.2
unnamed: IC27.4 (J1), IC32.10
unnamed: IC27.6 (Q1), IC28.2 (I0a)
unnamed: IC27.11 (Q2), IC28.5 (I0b)
unnamed: IC27.12 (J2), IC32.11
unnamed: IC27.13 (J3), IC32.1
unnamed: IC27.14 (Q3), IC28.14 (I0d)
unnamed: IC28.3 (I1a), S100.82
unnamed: IC28.4 (Za), IC41.1, IC42.1, IC43.1, IC44.1, IC45.1, IC46.1, IC47.1, IC48.1
unnamed: IC28.6 (I1b), S100.83
unnamed: IC28.7 (Zb), IC41.16, IC42.16, IC43.16, IC44.16, IC45.16, IC46.16, IC47.16, IC48.16
unnamed: IC28.9 (Zc), IC41.14, IC42.14, IC43.14, IC44.14, IC45.14, IC46.14, IC47.14, IC48.14
unnamed: IC28.10 (I1c), IC37.10, S100.34
unnamed: IC28.12 (Zd), IC41.15, IC42.15, IC43.15, IC44.15, IC45.15, IC46.15, IC47.15, IC48.15
unnamed: IC28.13 (I1d), IC37.9, S100.84
unnamed: IC29.1, S100.32
unnamed: IC29.3, S100.86
unnamed: IC29.5, S100.87
unnamed: IC29.9, IC36.3, IC37.5, IC38.15
unnamed: IC29.11, S100.37
unnamed: IC29.13, S100.33
unnamed: IC29.15, S100.85
unnamed: IC30.13, IC31.5, IC32.5, IC37.2, R40.2
unnamed: IC31.4, IC34.3, IC44.11, R46.2
unnamed: IC31.7, IC33.8, IC45.11, R48.2
unnamed: IC31.13, IC33.11, IC46.11, R45.2
unnamed: IC31.14, IC34.11, IC43.11, R41.2
unnamed: IC32.4, IC33.3, IC42.11, R43.2
unnamed: IC32.7, IC33.6, IC48.11, R47.2
unnamed: IC32.13, IC34.6, IC47.11, R44.2
unnamed: IC32.14, IC34.8, IC41.11, R42.2
unnamed: IC33.1, S100.89
unnamed: IC33.5, S100.36
unnamed: IC33.9, S100.38
unnamed: IC33.2, IC33.4, IC33.10, IC33.12, IC34.2, IC34.4, IC34.9, IC34.12, R49.2
unnamed: IC33.13, S100.39
unnamed: IC34.1, S100.40
unnamed: IC34.5, S100.35
unnamed: IC34.10, S100.88
unnamed: IC34.13, S100.90
unnamed: IC35.3, IC40.13
unnamed: IC35.5, IC36.2
unnamed: IC35.6, IC39.15
unnamed: IC35.8, IC38.14
unnamed: IC35.10, IC36.10
unnamed: IC35.11, IC38.1, IC39.1
unnamed: IC35.4, IC35.12, IC36.12, J5.2 (B)
unnamed: IC36.1, IC37.6, IC40.8
unnamed: IC36.4, IC40.9
unnamed: IC5.12, IC36.8
unnamed: IC36.9, IC38.4, IC46.12
unnamed: IC37.7, S100.77
unnamed: IC37.11, S100.46
unnamed: IC37.12, S100.45
unnamed: IC37.14, IC40.11
unnamed: IC5.5, IC38.2, IC45.12
unnamed: IC38.3, S100.91
unnamed: IC38.5, S100.92
unnamed: IC6.5, IC38.6, IC41.12
unnamed: IC38.7, S100.41
unnamed: IC38.9, S100.42
unnamed: IC6.12, IC38.10, IC42.12
unnamed: IC38.13, J2.2 (C)
unnamed: IC5.13, IC39.2, IC44.12
unnamed: IC39.3, S100.93
unnamed: IC6.13, IC39.4, IC47.12
unnamed: IC6.4, IC39.6, IC48.12
unnamed: IC39.9, S100.43
unnamed: IC5.4, IC39.10, IC43.12
unnamed: IC39.7, IC39.11, S100.95
unnamed: IC39.5, IC39.13, S100.94
unnamed: IC40.3, IC40.4, IC40.12
unnamed: J2.1 (A), S100.72
unnamed: J2.3 (B), S100.3
unnamed: J4.1 (A), S100.47
unnamed: R6.1, S100.52
unnamed: R33.3, R34.1
unnamed: R50.3, R51.1

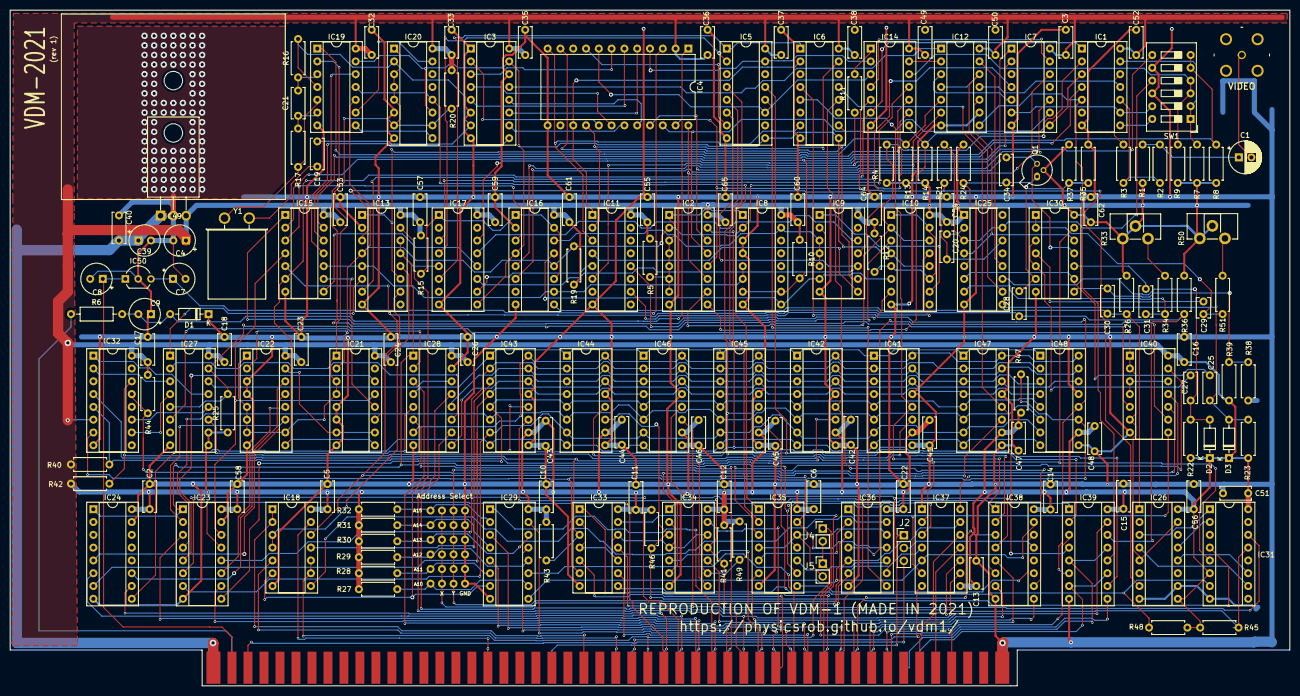
[picture p21: board vdm2021.kicad_pcb from above]

Board: 2 copper layers, 254.0 x 134.1 mm, 177 parts (0 on the bottom side), 231 nets.

Other parts of the board:
HEAT: Heat Sink; heatsink
VIDEO: Conn_Coaxial; bnc-5-16345033

Their connections:
GND: VIDEO.2; also elsewhere on the board
unnamed 12: VIDEO.1; also elsewhere on the board
