physicsrob/vdm1/(commit log)

2021-06-20 Placement close to done
    [vdm2.kicad_pcb]
2021-06-21 Very close to fully routed
    [vdm2.kicad_pcb, vdm2.sch]
2021-06-22 Fully routed
    [vdm2.kicad_pcb]
2021-06-25 really getting close
    [vdm2.kicad_pcb, vdm2.sch]
2021-06-25 Fixed s100 connector alignment
    [vdm2.kicad_pcb]
2021-06-28 Small redesign for better thermal performance
    [vdm2.kicad_pcb, vdm2.sch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]
2021-06-29 Could it be a final version?
    [vdm2.kicad_pcb]
2021-08-15 Cleanup structure
    [vdm2021.kicad_pcb, vdm2021.sch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]
2021-08-15 Fix IC36 net in schematic
    [vdm2021.sch]
2021-08-16 Routing updates after last schematic change
    [vdm2021.kicad_pcb, vdm2021.sch]
2021-08-16 Fixed IC22 load value
    [vdm2021.kicad_pcb, vdm2021.sch]
2021-08-16 Fixed IC39 Gnd/pwr swap
    [vdm2021.kicad_pcb, vdm2021.sch]
2021-08-16 Fix Q1 pinout
    [vdm2021.kicad_pcb, vdm2021.sch]
2021-08-16 Silkscreen tweaks
    [vdm2021.kicad_pcb]
2021-08-16 Added interactive BOM
2021-08-20 Misc PCB
    [vdm2021.kicad_pcb]
2021-08-20 Added rev silkscreen
    [vdm2021.kicad_pcb]
2021-08-20 Added gerber
2021-08-23 Added board image
2021-08-29 Updated silkscreen URL. Increased footprint size of R6 half watt resistor
    [vdm2021.kicad_pcb, vdm2021.sch]
2021-08-30 Updated confusing silkscreen for C39
    [vdm2021.kicad_pcb]
2021-09-07 Assembly directions
2021-09-07 Moved video closer to top-edge. Moved VDM-2021 silkscreen to left edge
    [vdm2021.kicad_pcb]
2021-11-21 Update assembly
